ChrisBrinton/GDEnvSensor/PCBs/BME280_Daughter_1_0/BME280_Daughter.brd

## EAGLE design PCBs/BME280_Daughter_1_0/BME280_Daughter.brd (2017-10-19)

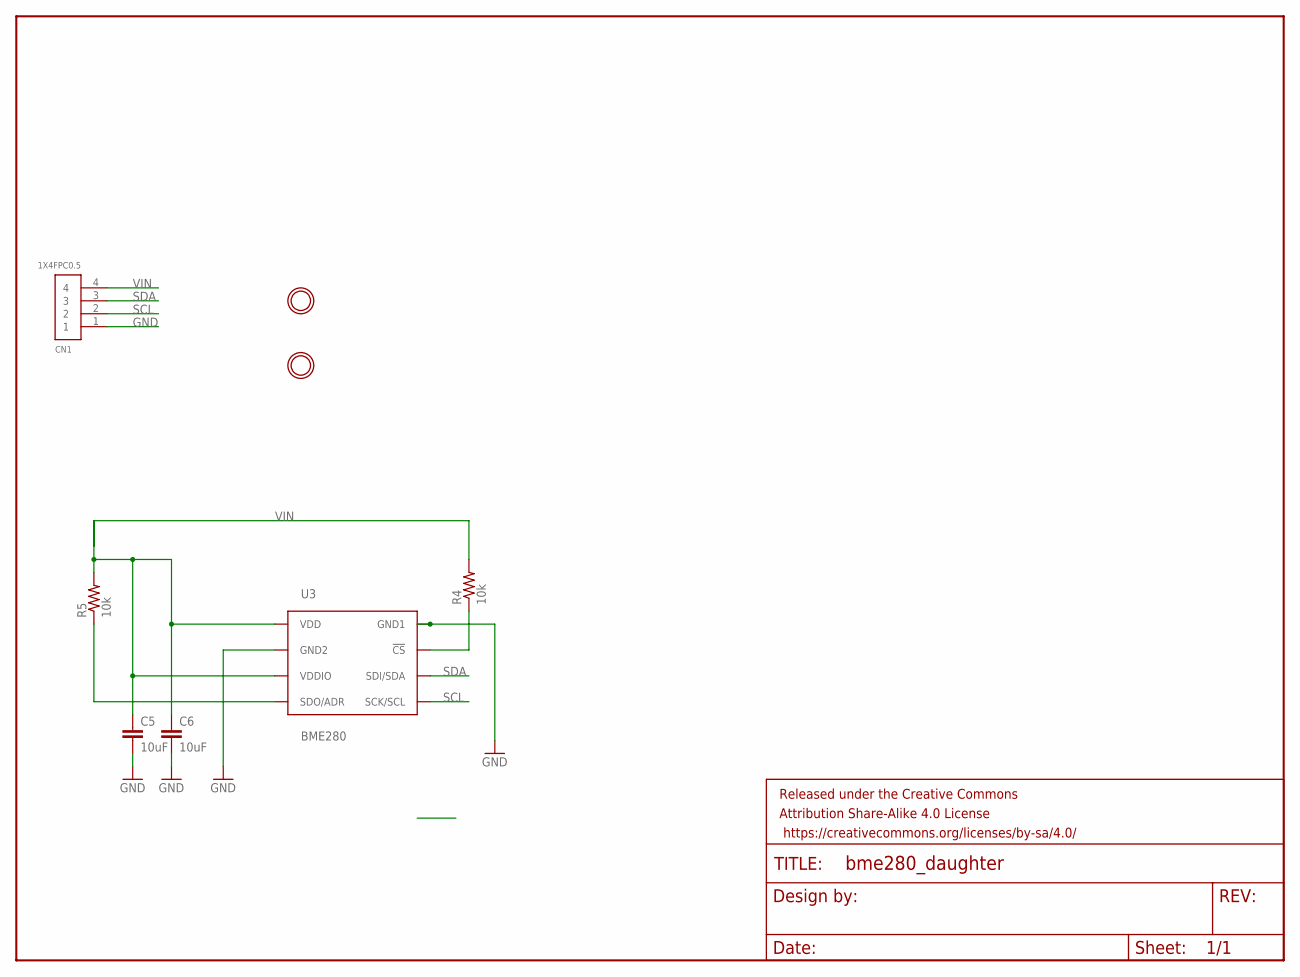
[picture p1: schematic BME280_Daughter.sch]

Parts:
C5, C6: 10uF; 0805
CN1: 1X4FPC0.5; FPC_0.5MM-4
FRAME1: FRAME-LETTER; CREATIVE_COMMONS
R4, R5: 10k; 0805
U3: BME280; BME280_LGA
U$1, U$2: MOUNTINGHOLE2.0; MOUNTINGHOLE_2.0_PLATED

Connections:
GND: C5.2, C6.2, CN1.1, U3.P$1 (GND1), U3.P$7 (GND2)
unnamed: R4.1, U3.P$2 (!CS)
unnamed: R5.1, U3.P$5 (SDO/ADR)
SCL: CN1.2, U3.P$4 (SCK/SCL)
SDA: CN1.3, U3.P$3 (SDI/SDA)
VIN: C5.1, C6.1, CN1.4, R4.2, R5.2, U3.P$6 (VDDIO), U3.P$8 (VDD)

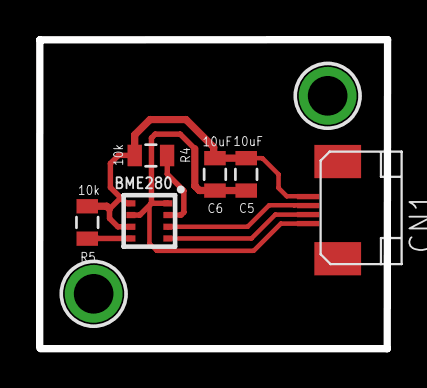
[picture p2: board BME280_Daughter.brd from above]

Board: 2 copper layers, 19.3 x 17.2 mm, 9 parts (0 on the bottom side), 6 nets.
