ChrisBrinton/GDEnvSensor/PCBs/GDEnvSensorNode_1_3b/GDEnvSensorNode_1_3b.brd

## EAGLE design PCBs/GDEnvSensorNode_1_3b/GDEnvSensorNode_1_3b.brd (2017-10-19)

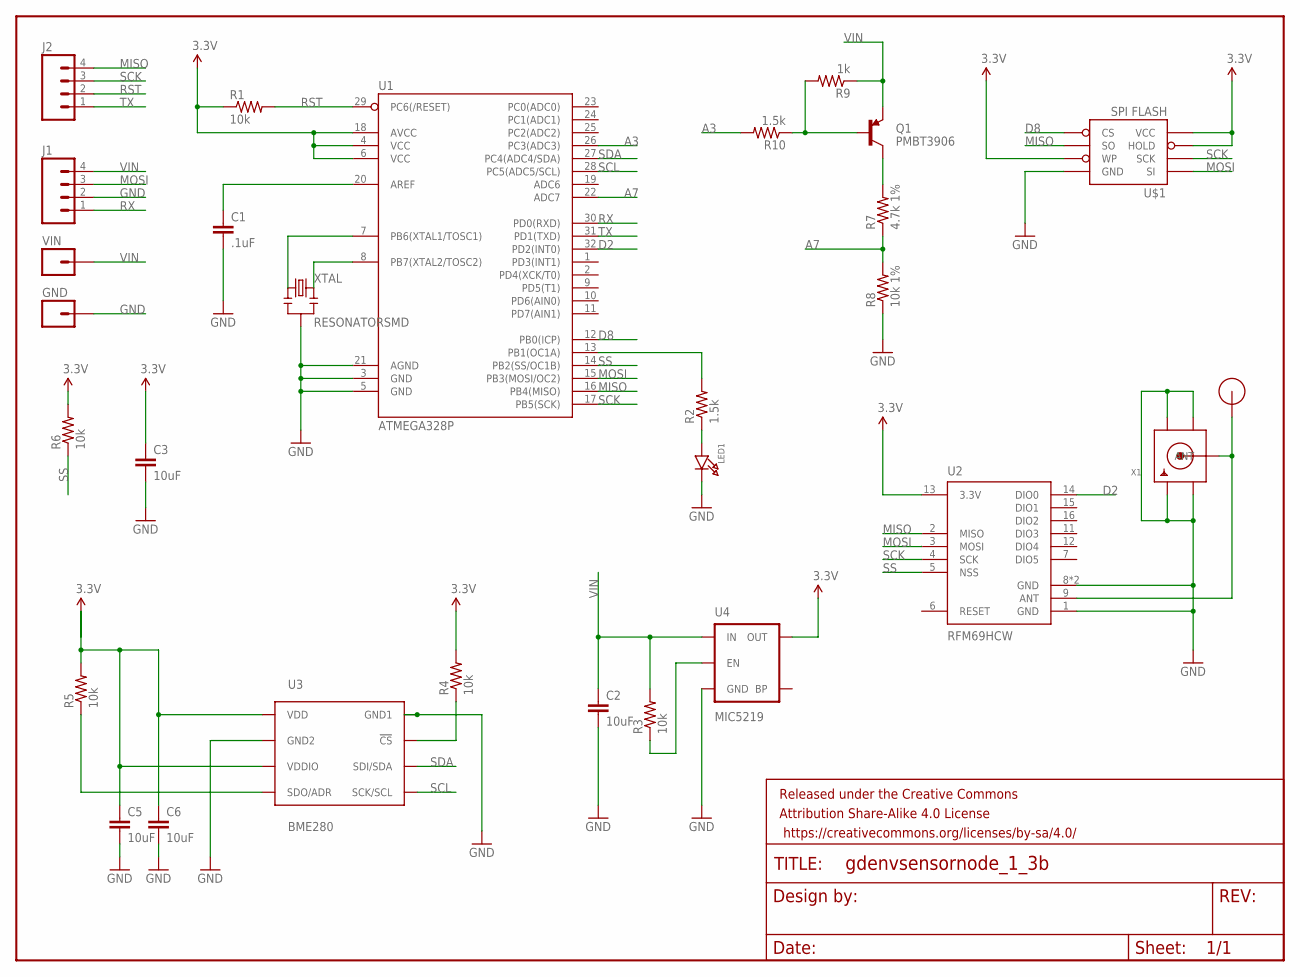
[picture p3: schematic GDEnvSensorNode_1_3b.sch]

Parts:
C1: .1uF; 0805
C2, C3, C5, C6: 10uF; 0805
FRAME1: FRAME-LETTER; CREATIVE_COMMONS
GND: M01PTH_2MM; 1X01_2MM
J1, J2: M04PTH; 1X04
LED1: LED0805; CHIPLED_0805
Q1: PMBT3906; SOT23-3
R1, R3, R4, R5, R6: 10k; 0805
R2, R10: 1.5k; 0805
R7: 4.7k 1%; 0805
R8: 10k 1%; 0805
R9: 1k; 0805
U1: ATMEGA328P; TQFP32-08
U2: RFM69HCW; RFM69HCW-XXXS2
U3: BME280; BME280_LGA
U4: MIC5219; SOT23-5
U$1: SPI FLASH; SO08
U$4: RFM12B_ANTENNA; RFM12B-ANTENNA
VIN: M01PTH_2MM; 1X01_2MM
X1: SMACONNECTOR_EDGE_UFL; SMA_EDGELAUNCH_UFL
XTAL: RESONATORSMD; RESONATOR-SMD

Connections:
3.3V: C3.1, R1.1, R4.2, R6.2, U1.4 (VCC), U1.6 (VCC), U1.18 (AVCC), U2.13 (3.3V), U4.5 (OUT), U$1.3_WP (WP), U$1.7_HOLD (HOLD), U$1.8_VCC (VCC)
A3: R10.2, U1.26 (PC3(ADC3))
A7: R7.1, R8.2, U1.22 (ADC7)
ANT: U2.9 (ANT), U$4.P$1, X1.P (ANT)
D2: U1.32 (PD2(INT0)), U2.14 (DIO0)
D8: U1.12 (PB0(ICP)), U$1.1_CS (CS)
GND: C1.2, C2.2, C3.2, C5.2, C6.2, GND.1, J1.2, LED1.C, R8.1, U1.3 (GND), U1.5 (GND), U1.21 (AGND), U2.1 (GND), U2.8 (GND), U2.10 (GND), U3.P$1 (GND1), U3.P$7 (GND2), U4.2 (GND), U$1.4_GND (GND), X1.GND@1 (GND1), X1.GND@2 (GND2), X1.GND@3 (GND3), X1.GND@4 (GND4), XTAL.2
MISO: J2.4, U1.16 (PB4(MISO)), U2.2 (MISO), U$1.2_SO (SO)
MOSI: J1.3, U1.15 (PB3(MOSI/OC2)), U2.3 (MOSI), U$1.5_SI (SI)
unnamed: U1.8 (PB7(XTAL2/TOSC2)), XTAL.3
unnamed: U1.7 (PB6(XTAL1/TOSC1)), XTAL.1
unnamed: LED1.A, R2.1
unnamed: R4.1, U3.P$2 (!CS)
unnamed: R2.2, U1.13 (PB1(OC1A))
unnamed: R3.1, U4.3 (EN)
unnamed: Q1.1 (B), R9.2, R10.1
unnamed: Q1.3 (C), R7.2
unnamed: C1.1, U1.20 (AREF)
unnamed: C5.1, C6.1, R5.2, U3.P$6 (VDDIO), U3.P$8 (VDD)
unnamed: R5.1, U3.P$5 (SDO/ADR)
RST: J2.2, R1.2, U1.29 (PC6(/RESET))
RX: J1.1, U1.30 (PD0(RXD))
SCK: J2.3, U1.17 (PB5(SCK)), U2.4 (SCK), U$1.6_SCK (SCK)
SCL: U1.28 (PC5(ADC5/SCL)), U3.P$4 (SCK/SCL)
SDA: U1.27 (PC4(ADC4/SDA)), U3.P$3 (SDI/SDA)
SS: R6.1, U1.14 (PB2(SS/OC1B)), U2.5 (NSS)
TX: J2.1, U1.31 (PD1(TXD))
VIN: C2.1, J1.4, Q1.2 (E), R3.2, R9.1, U4.1 (IN), VIN.1

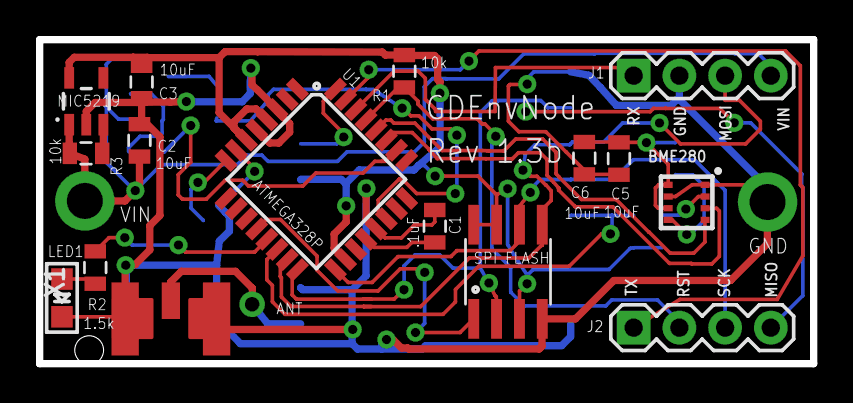
[picture p4: board GDEnvSensorNode_1_3b.brd from above]

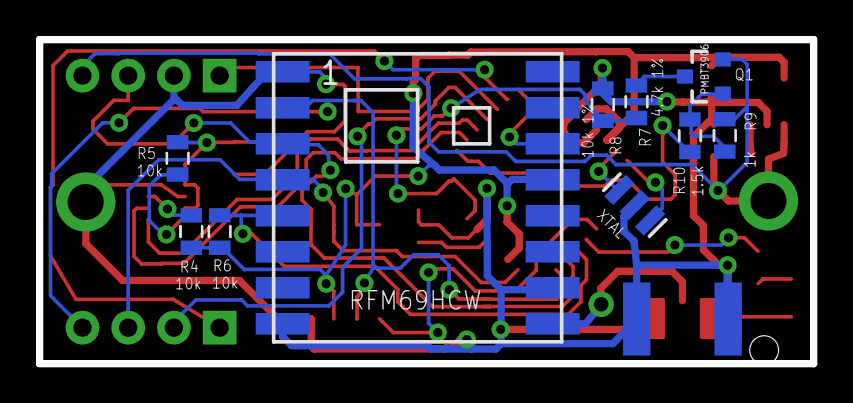
[picture p5: board GDEnvSensorNode_1_3b.brd from below]

Board: 2 copper layers, 43.0 x 18.0 mm, 30 parts (10 on the bottom side), 28 nets.
