ChrisBrinton/GDEnvSensor/PCBs/GDEnvSensorNode_Programmer_one_sided/GDEnvSensorNode_Programmer.brd

## EAGLE design PCBs/GDEnvSensorNode_Programmer_one_sided/GDEnvSensorNode_Programmer.brd (2017-10-19)

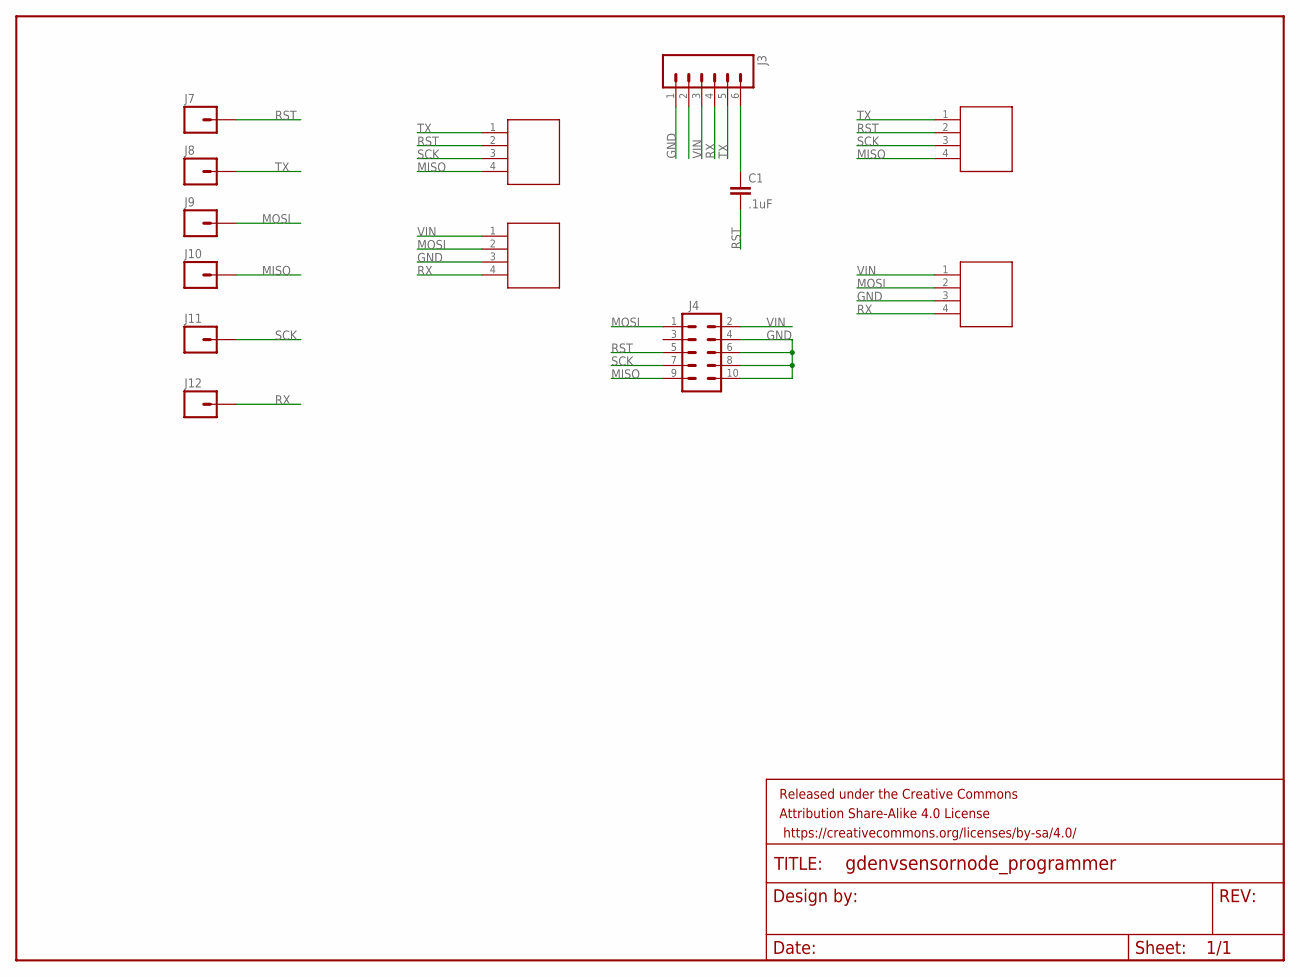
[picture p8: schematic GDEnvSensorNode_Programmer.sch]

Parts:
C1: .1uF; 0805
FRAME1: FRAME-LETTER; CREATIVE_COMMONS
J1, J2, J5, J6: 4X.1IN_POGO_PIN
J3: M06LONGPADS; 1X06_LONGPADS
J4: M05X2PTH; AVR_ICSP
J7, J8, J9, J10, J11, J12: M01PTH; 1X01

Connections:
GND: J2.3, J3.1, J4.4, J4.6, J4.8, J4.10, J6.3
MISO: J1.4, J4.9, J5.4, J10.1
MOSI: J2.2, J4.1, J6.2, J9.1
unnamed: C1.1, J3.6
RST: C1.2, J1.2, J4.5, J5.2, J7.1
RX: J2.4, J3.4, J6.4, J12.1
SCK: J1.3, J4.7, J5.3, J11.1
TX: J1.1, J3.5, J5.1, J8.1
VIN: J2.1, J3.3, J4.2, J6.1

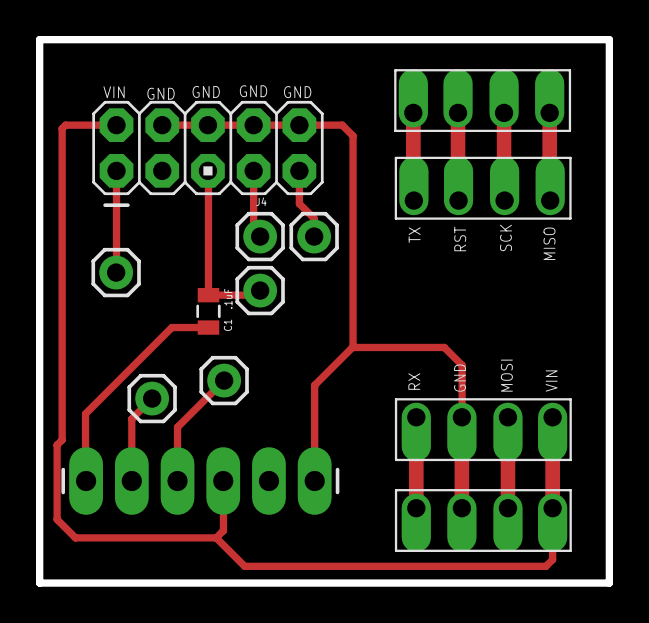
[picture p9: board PCBs/GDEnvSensorNode_Programmer_one_sided/GDEnvSensorNode_Programmer.… from above]

Board: 2 copper layers, 31.6 x 30.2 mm, 14 parts (0 on the bottom side), 9 nets.
