ChrisBrinton/GDEnvSensor/firmware/GDEnvSensGW/src/main.ino

/*

ESP69GW
MAIN MODULE

ESP8266 to RFM69 Gateway
Gateway code with suport for ESP8266-based boards

Copyright (C) 2016-2017 by Xose Pérez <xose dot perez at gmail dot com>

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
*/

#include <Arduino.h>
#include "config/all.h"

// -----------------------------------------------------------------------------
// Prototypes
// -----------------------------------------------------------------------------

#include <NtpClientLib.h>
#include <ESPAsyncWebServer.h>
#include <AsyncMqttClient.h>
#include "RFM69Manager.h"
#include "FS.h"
#include "NodeList.h"
template<typename T> String getSetting(const String& key, T defaultValue);
template<typename T> bool setSetting(const String& key, T value);

struct _GDnode_t {
  String RSSI = "";
  String BAT = "";
  String F = "";
  String H = "";
  String P = "";
};

struct _node_t {
  unsigned long count = 0;
  unsigned long missing = 0;
  unsigned long duplicates = 0;
  unsigned char lastPacketID = 0;
  _GDnode_t* THP;
};

_node_t nodeInfo[255];

NodeList nodeList;

//
// -----------------------------------------------------------------------------
// METHODS
// -----------------------------------------------------------------------------


String getIdentifier() {
    char identifier[20];
    sprintf(identifier, "%s_%06X", DEVICE, ESP.getChipId());
    return String(identifier);
}

void ledOn() {
    digitalWrite(LED_PIN, LOW);
}

void ledOff() {
    digitalWrite(LED_PIN, HIGH);
}

void blink(unsigned int delayms, unsigned char times = 1) {
    for (unsigned char i=0; i<times; i++) {
        if (i>0) delay(delayms);
        ledOn();
        delay(delayms);
        ledOff();
    }
}

void clearCounts() {
    for(unsigned int i=0; i<255; i++) {
        nodeInfo[i].duplicates = 0;
        nodeInfo[i].missing = 0;
    }
}

void processMessage(packet_t * data) {

    blink(5, 1);

    DEBUG_MSG(
        "[MESSAGE] messageID:%d senderID:%d targetID:%d packetID:%d rssi:%d\n",
        data->messageID,
        data->senderID,
        data->targetID,
        data->packetID,
        data->rssi
    );

    for (uint8_t i=0;i<data->pairCount;i++){
      DEBUG_MSG("[MESSAGE] name: %s value: %s\n", data->pairs[i].name, data->pairs[i].value);
    }

    // Detect duplicates and missing packets
    // packetID==0 means device is not sending packetID info
    if (data->packetID > 0) {
        if (nodeInfo[data->senderID].count > 0) {

            unsigned char gap = data->packetID - nodeInfo[data->senderID].lastPacketID;

            if (gap == 0) {
                DEBUG_MSG(" DUPLICATED\n");
                nodeInfo[data->senderID].duplicates = nodeInfo[data->senderID].duplicates + 1;
                return;
            }

            if ((gap > 1) && (data->packetID > 1)) {
                DEBUG_MSG(" MISSING PACKETS!!\n");
                nodeInfo[data->senderID].missing = nodeInfo[data->senderID].missing + gap - 1;
            }
        }

    }

    nodeInfo[data->senderID].lastPacketID = data->packetID;
    nodeInfo[data->senderID].count = nodeInfo[data->senderID].count + 1;

    if(nodeInfo[data->senderID].THP == 0) {
      nodeInfo[data->senderID].THP = new _GDnode_t;
    }
    nodeInfo[data->senderID].THP->RSSI = data->rssi;

    if(!nodeList.nodeExists(data->senderID)){
      nodeList.insertNode(data->senderID);
    }
    DEBUG_MSG("\n");

    //Set the time that we got the message. If it goes too long without another update, the diplay routing will clear is out.
    nodeList.setUpdateTime(data->senderID, time(NULL));

    String tmpTopic;
    for (uint8_t j=0;j<data->pairCount;j++){
      //TODO: Replace with linked list code to hold node data for the display.
      if(strncmp(data->pairs[j].name,"F",1) == 0){
        nodeInfo[data->senderID].THP->F = data->pairs[j].value;
      }
      if(strncmp(data->pairs[j].name,"H",1) == 0){
        nodeInfo[data->senderID].THP->H = data->pairs[j].value;
      }
      if(strncmp(data->pairs[j].name,"P",1) == 0){
        nodeInfo[data->senderID].THP->P = data->pairs[j].value;
      }
      if(strncmp(data->pairs[j].name,"BAT",1) == 0){
        nodeInfo[data->senderID].THP->BAT = data->pairs[j].value;
      }
      // Send info to websocket clients
      char buffer[60];
      sprintf_P(
          buffer,
          PSTR("{\"packet\": {\"senderID\": %u, \"targetID\": %u, \"packetID\": %u, \"name\": \"%s\", \"value\": \"%s\", \"rssi\": %d, \"duplicates\": %d, \"missing\": %d}}"),
          data->senderID, data->targetID, data->packetID, data->pairs[j].name, data->pairs[j].value, data->rssi,
          nodeInfo[data->senderID].duplicates , nodeInfo[data->senderID].missing);
      wsSend(buffer);

      // Try to find a matching mapping
      bool found = false;
      unsigned int count = getSetting("mappingCount", "0").toInt();
      for (unsigned int i=0; i<count; i++) {
          if ((getSetting("nodeid" + String(i)) == String(data->senderID)) &&
              (getSetting("key" + String(i)) == data->pairs[j].name)) {
              mqttSend((char *) getSetting("topic" + String(i)).c_str(), (char *) String(data->pairs[j].value).c_str());
              found = true;
              tmpTopic = String(getSetting("topic" + String(i)).c_str()) + String("RSSI/");
              break;
          }
      }

      if (!found) {
          String topic = getSetting("defaultTopic", MQTT_DEFAULT_TOPIC);
          if (topic.length() > 0) {
              topic.replace("{nodeid}", String(data->senderID));
              topic.replace("{key}", String(data->pairs[j].name));
              String tmpHN = String(getSetting("hostname", APP_NAME));
              tmpHN.replace("_","/");
              topic.replace("{hostname}", tmpHN);
              topic += "/";
              mqttSend((char *) topic.c_str(), (char *) String(data->pairs[j].value).c_str());
              tmpTopic = getSetting("defaultTopic", MQTT_DEFAULT_TOPIC);
              tmpTopic.replace("{nodeid}", String(data->senderID));
              tmpTopic.replace("{key}", String("RSSI"));
              tmpTopic.replace("{hostname}", tmpHN);
              tmpTopic += "/";

          }
      }
    }
    mqttSend((char *) tmpTopic.c_str(), (char *) String(data->rssi).c_str());
}

// -----------------------------------------------------------------------------
// Hardware
// -----------------------------------------------------------------------------

void hardwareSetup() {
    Serial.begin(SERIAL_BAUDRATE);
    SPIFFS.begin();
    pinMode(LED_PIN, OUTPUT);
    ledOff();
}

void hardwareLoop() {

    // Heartbeat
    static unsigned long last_heartbeat = 0;
    if (mqttConnected()) {
        if ((millis() - last_heartbeat > HEARTBEAT_INTERVAL) || (last_heartbeat == 0)) {
            last_heartbeat = millis();
            mqttSend((char *) getSetting("hbTopic", MQTT_HEARTBEAT_TOPIC).c_str(), (char *) "1");
            DEBUG_MSG("[BEAT] Free heap: %d\n", ESP.getFreeHeap());
            DEBUG_MSG("[NTP] Time: %s\n", (char *) NTP.getTimeDateString().c_str());
        }
    }

}

void welcome() {

    delay(2000);
    Serial.printf("%s %s\n", (char *) APP_NAME, (char *) APP_VERSION);
    Serial.printf("%s\n%s\n\n", (char *) APP_AUTHOR, (char *) APP_WEBSITE);
    //Serial.printf("Device: %s\n", (char *) getIdentifier().c_str());
    Serial.printf("ChipID: %06X\n", ESP.getChipId());
    Serial.printf("Last reset reason: %s\n", (char *) ESP.getResetReason().c_str());
    Serial.printf("Memory size: %d bytes\n", ESP.getFlashChipSize());
    Serial.printf("Free heap: %d bytes\n", ESP.getFreeHeap());
    FSInfo fs_info;
    if (SPIFFS.info(fs_info)) {
        Serial.printf("File system total size: %d bytes\n", fs_info.totalBytes);
        Serial.printf("            used size : %d bytes\n", fs_info.usedBytes);
        Serial.printf("            block size: %d bytes\n", fs_info.blockSize);
        Serial.printf("            page size : %d bytes\n", fs_info.pageSize);
        Serial.printf("            max files : %d\n", fs_info.maxOpenFiles);
        Serial.printf("            max length: %d\n", fs_info.maxPathLength);
    }
    Serial.println();
    Serial.println();

}

// -----------------------------------------------------------------------------
// Bootstrap methods
// -----------------------------------------------------------------------------

void setup() {

    hardwareSetup();

    welcome();

    settingsSetup();
    if (getSetting("hostname").length() == 0) {
        setSetting("hostname", String() + getIdentifier());
        saveSettings();
    }

    wifiSetup();
    otaSetup();
    mqttSetup();
    radioSetup();
    webSetup();
    ntpSetup();
    sensorSetup();
    displaySetup();

}

void loop() {

    hardwareLoop();
    settingsLoop();
    wifiLoop();
    otaLoop();
    mqttLoop();
    radioLoop();
    ntpLoop();
    sensorLoop();
    displayLoop();

    yield();

}
