ChrisBrinton/GDEnvSensor/firmware/GDEnvSensGW/src/config/version.h

#define APP_NAME                "GDESGW1"
#define APP_VERSION             "1.0.1"
#define APP_AUTHOR              "cbrinton@gmail.com"
#define APP_WEBSITE             "https://github.com/ChrisBrinton/EnvironmentSensor"
